Kanken6174/esp_wake/(list of files, drawings)

Other design files:
hardware/circuit/ProDocument_backend_V0.5_2024-01-22.epro
hardware/circuit/ProDocument_frontend_2024-01-22.epro
