Kanken6174/esp_wake/src/Alarms.hpp

#include "EspSD.hpp"
#include <vector>

class Alarm{
  public:
    int hour;
    int minute;
    int second;
    int day;  //1-7 week days; 0 = any day; 8 - any week day; 9 - any weekend day
    bool active;
    bool ringing = false;
};

class AlarmManager{
  protected:
    int previousDay = -1;
    int previousHour = -1;
    int previousMinute = -1;
    int previousSecond = -1;

    std::vector<Alarm> alarms;
    EspSD _sd;
  public:
    AlarmManager(){}
    void begin(const EspSD& sd); // load alarms from SD
    bool process(); //check alarms, true if alarm should be ringing
    void snooze();
    void reloadAlarms();
};
