Kanken6174/esp_wake/src/ATH20.hpp

/*
Datasheet can be found here: https://asairsensors.com/wp-content/uploads/2021/09/Data-Sheet-AHT20-Humidity-and-Temperature-Sensor-ASAIR-V1.0.03.pdf
*/

#define STATUS_WORD 0x18
#define STATUS_WORD_CMD 0x71
#include <Adafruit_AHTX0.h>
