Kanken6174/esp_wake/src/charDict.hpp

const bool CEMPTY[5][3] = {
    {0, 0, 0},
    {0, 0, 0},
    {0, 0, 0},
    {0, 0, 0},
    {0, 0, 0}
};

const bool CZERO[5][3] = {
    {1, 1, 1},
    {1, 0, 1},
    {1, 0, 1},
    {1, 0, 1},
    {1, 1, 1}
};

const bool CONE[5][3] = {
    {0, 1, 0},
    {1, 1, 0},
    {0, 1, 0},
    {0, 1, 0},
    {1, 1, 1}
};

const bool CTWO[5][3] = {
    {1, 1, 1},
    {0, 0, 1},
    {1, 1, 1},
    {1, 0, 0},
    {1, 1, 1}
};

const bool CTHREE[5][3] = {
    {1, 1, 1},
    {0, 0, 1},
    {1, 1, 1},
    {0, 0, 1},
    {1, 1, 1}
};

const bool CFOUR[5][3] = {
    {1, 0, 1},
    {1, 0, 1},
    {1, 1, 1},
    {0, 0, 1},
    {0, 0, 1}
};

const bool CFIVE[5][3] = {
    {1, 1, 1},
    {1, 0, 0},
    {1, 1, 1},
    {0, 0, 1},
    {1, 1, 1}
};

const bool CSIX[5][3] = {
    {1, 1, 1},
    {1, 0, 0},
    {1, 1, 1},
    {1, 0, 1},
    {1, 1, 1}
};

const bool CSEVEN[5][3] = {
    {1, 1, 1},
    {0, 0, 1},
    {0, 1, 0},
    {0, 1, 0},
    {0, 1, 0}
};

const bool CEIGHT[5][3] = {
    {1, 1, 1},
    {1, 0, 1},
    {1, 1, 1},
    {1, 0, 1},
    {1, 1, 1}
};

const bool CNINE[5][3] = {
    {1, 1, 1},
    {1, 0, 1},
    {1, 1, 1},
    {0, 0, 1},
    {1, 1, 1}
};

const bool CFULL[5][3] = {
    {1, 1, 1},
    {1, 1, 1},
    {1, 1, 1},
    {1, 1, 1},
    {1, 1, 1}
};
