Kanken6174/esp_wake/(commit log)

2023-09-25 switched to pio
2023-09-26 added oled functionnality, and fixed alarms
    [Alarms.cpp, _esp_wake.ino, extScreen.hpp]
2023-09-26 web server up but writing doesn't work
    [Alarms.cpp, Alarms.hpp, _esp_wake.ino, web.cpp, web.hpp]
2023-09-27 fixed web based alarm editing and sticky snooze
    [Alarms.cpp, Alarms.hpp, _esp_wake.ino, web.cpp]
2023-12-02 working audio but crashes upon task exit?
    [EspSD.hpp, SoundI2S.cpp, SoundI2S.hpp, _esp_wake.ino, pixelFront.cpp, pixelFront.hpp, wifiTime.hpp]
2023-12-02 fixed crashing issue and other sound related bugs
    [SoundI2S.cpp]
2023-12-02 trying to fix end logic
    [SoundI2S.hpp]
2023-12-02 fixed more bugs, it's working pretty well now!
    [SoundI2S.cpp]
2023-12-10 fixed snooze not working, disabled data acquisition
    [SoundI2S.cpp, _esp_wake.ino]
2024-01-22 going open source
    [ProDocument_backend_V0.5_2024-01-22.epro, ProDocument_frontend_2024-01-22.epro]
2025-06-28 fixed what was broken
    [SoundI2S.cpp, SoundI2S.hpp, _esp_wake.ino, web.cpp, web.hpp]
